barabel/steevenson-screen/docs/phases/README.md

# Щит для POK005L — фазы

> Утверждено картой `.scratch/shield/map.md` (тикет «Утвердить план фаз»).

ТЗ: [PLAN.md](../PLAN.md). Термины: [GLOSSARY.md](../../GLOSSARY.md).

Порядок — сверху вниз от Скелета: сначала точный Датчик, потом Скелет всего Щита из Черновиков, потом детализация деталей, каждая берёт размеры из Скелета. Spec фазы пишется в её grilling-сессии: `.scratch/<фаза>/spec.md`.

Все Стыки — именованные параметры Скелета в одном файле. Фазы их только читают; поменять Стык — править Скелет и запустить Прогон. Поэтому фазы 4, 5, 6 друг от друга не зависят и идут в любом порядке.

## 0. Окружение

- **статус**: готово (PR #1)
- **цель**: воспроизводимый Прогон из VS Code
- **вход**: —
- **выход**: структура репо (`res/` — внешние ресурсы, только чтение; `src/` — наш код; `dist/` — результат Прогона, в `.gitignore`); `build.cmd` (или Ctrl+Shift+B) делает Прогон и сохраняет `dist/shield.FCStd`, `build.cmd test` запускает тесты; заготовка проверок геометрии (битое тело или пересечение деталей роняет Прогон с понятной ошибкой, каждая фаза добавляет свои); Прогон сохраняет PNG-виды сцены (спереди, сбоку, сечение по оси) в `dist/views/`, чтобы агент видел результат. Резервный путь рендера, если offscreen в FreeCAD сломается: GUI-рендер `freecad.exe` или OpenSCAD по экспортированным STL
- **готово, когда**: один запуск `build.cmd` из терминала VS Code даёт файл, который открывается в FreeCAD, и PNG-виды; намеренно битое тело роняет Прогон

## 1. Контрольная сцена Датчика

- **статус**: готово
- **цель**: узнать реальную геометрию Датчика
- **вход**: 0
- **выход**: импорт STL половин Корпуса и Вешалки, половины свинчены, понятно как Ушко цепляется за Вешалку; реальный габарит Датчика и упрощённое тело — Заглушка
- **готово, когда**: габарит собранного Датчика измерен в сцене, Заглушка его повторяет

## 2. Скелет Щита

- **статус**: готово
- **цель**: общая параметрическая модель всего Щита из Черновиков
- **вход**: 1
- **выход**: параметры и оси, Черновики всех деталей (Тарелки, Нижняя Тарелка с резьбовым кольцом, Крышка, Стойки, Дно, Держатель, Кронштейн), Заглушка внутри на Крючке Держателя. Стыки — параметры в одном файле `src/skeleton/params.py`, стартовые значения, мм:
  - Тарелки: наружный Ø 140, Ø отверстия 76, N = 6 (с Нижней, без Крышки), шаг 16
  - Крышка↔Кронштейн: Точка подвеса (центр верха Крышки, ось болта = ось Щита), болт M6, Проставка 20
  - Тарелки/Крышка↔Стойки: 4 Стойки на радиусе 54, отверстие 4.5 под Шпильку M4
  - Дно↔Нижняя Тарелка: резьба Ø 90 × шаг 5, наклон стороны 45°, зазор 0.5 по нормали к профилю (ориентир SanglierLab с запасом, без печати Пробника)
  - Щит↔Откос: от Фасада до края Тарелок 150, сдвиг вбок от плоскости Откоса 100
  - Датчик↔Держатель: форма Крючка (из фазы 1)

  От Фасада до оси Щита выводится: 150 + радиус Тарелки = **220** при Ø 140. После фазы 4: Ø 154, N = 7, **227**
- **готово, когда**: все Стыки — параметры в одном файле; после смены диаметра Щита и числа Тарелок Прогон строит Скелет без ошибок; Заглушка не ближе 10 мм ни к одному телу, кроме Держателя; Дно с Держателем и Датчиком выходит вниз без столкновений; проверки фазы 0 проходят

## 3. Пробник резьбы

- **статус**: закрыта без печати. Принтер друга сломался, все детали печатаются одним заказом в мастерской. Зазор в Скелете — 0.5: ориентир SanglierLab с запасом; не подойдёт — перепечатать Дно (весь зазор на нём, кольцо Нижней Тарелки номинальное)
- **цель**: модуль резьбы для Дна и Нижней Тарелки; печать Пробника отменена
- **вход**: 2 (диаметр, шаг, зазор резьбы)
- **выход**: модуль резьбы для Нижней Тарелки (фаза 4) и Дна (фаза 5); Пробник — 4 кольца на один стол (Кольцо Тарелки и Кольца Дна 0.3 / 0.4 / 0.5), `dist/coupon.FCStd` и STL в `dist/coupon/`. Прогон строит Пробник и дальше: его проверка пары — тест модуля резьбы
- **готово, когда**: Прогон строит Пробник, проверки пары проходят; зазор записан в Скелет

## 4. Тарелки и стопка

- **статус**: готово
- **цель**: Тарелки, которые закрывают Носик от солнца
- **вход**: 2, 3 (модуль резьбы)
- **выход**: профиль Тарелки по мотивам SanglierLab — Полка у отверстия, Капельник, конус 45° от наружного края Полки; печать Полкой на стол без поддержек. Тарелки ×N (N = 7 с Нижней, без Крышки), Ø 154. Крышка с плоским верхом, снизу — гнездо под гайку M6 болта подвеса (гайку вставляют при Сборке). Нижняя Тарелка без Капельника, резьбовое кольцо с витками модулем резьбы фазы 3, номинальный размер. Стойки на Полке под Шпильки M4, гайки M4 с шайбами снаружи: на верху Крышки и под Полкой Нижней Тарелки. Новые проверки Прогона: тень, просвет, шайба у кольца
- **готово, когда**: прямое солнце на высоте 0–90° с любого направления не попадает ни в одну точку Заглушки; просвет между соседними Тарелками ≥ 9 мм; Прогон и все проверки проходят

## 5. Дно и Держатель

- **статус**: готово
- **цель**: съёмное Дно с Датчиком
- **вход**: 2, 3
- **выход**: Дно — одна деталь: сверху Диск, он упирается в низ Полки Нижней Тарелки (единственный упор); вниз от него Обечайка с наружной резьбой модулем резьбы фазы 3, зазор из Скелета (0.5), весь на Дне; ниже резьбового кольца с зазором — рифлёный хват, верх скошен 45°; дренаж — отверстия в Диске по окружности. Печать Диском на стол без поддержек. Держатель — одна деталь: Пятка на Диске, пластина за спиной Корпуса, Крючок по форме Вешалки (одна дуга, кончик вверх) заодно с Держателем; печать на боку. Держатель на двух винтах M4 через Диск и Пятку: головки снизу, гайки с шайбами на Пятке. Датчик висит Носиком вниз. Новые проверки Прогона: висит на Крючке, пара резьб; выход вниз — путь Дна с Нижней Тарелкой не сравнивается
- **готово, когда**: Заглушка висит на Крючке Носиком вниз; пара резьб и выход вниз проходят; Прогон и все проверки проходят

## 6. Кронштейн

- **цель**: Щит висит на покупном Кронштейне за Крышку

Кронштейн ещё не куплен, поэтому фаза разделена: 6а — форма по ориентировочным размерам сейчас, 6б — обмер после покупки. Проверки 6а — критерии покупки в модели: в 6б Прогон с обмером скажет, подходит ли купленное.

### 6а. Форма и Проставка по ориентировочным размерам

- **статус**: готово
- **вход**: 2 (Точка подвеса, болт M6, высота Проставки), 4 (верх Крышки с гнездом гайки M6), форма по эскизу [docs/sketches/kronshtein-na-otkose.html](../sketches/kronshtein-na-otkose.html). Spec: `.scratch/bracket/spec.md`
- **выход**: пакет Кронштейна `src/bracket/` вместо Черновика Кронштейна, Черновиков в Скелете больше нет. Уголок — вдоль Откоса от рамы за Фасад; Поворот — стойкой вверх, с подкосом, на двух болтах M6 к концу Уголка, плечо внизу. Проставка с пазом под плечо Поворота, печать низом на стол. Стык Щит↔Откос: от Фасада до края Тарелок 150, сдвиг оси Щита вбок от плоскости Откоса 100. Новые проверки Прогона: «сбоку от Щита пусто», «гайки в углу», «ключ к болту». Прогон пишет в лог длину Уголка и положение болта подвеса на Повороте
- **готово, когда**: Прогон и все проверки проходят

### 6б. Обмер купленного

- **статус**: —
- **вход**: 6а; купленные и обмеренные Уголок и Поворот (что купить и что обмерить — тикет [.scratch/bracket/issues/01-chto-kupit.md](../../.scratch/bracket/issues/01-chto-kupit.md))
- **выход**: обмер в параметрах Скелета `src/skeleton/params.py`, код моделей не меняется
- **готово, когда**: Прогон с обмером проходит

## 7. Печать

- **статус**: —
- **цель**: детали готовы к печати
- **вход**: 4, 5, 6; замер собранного Датчика штангенциркулем, сверка с параметрами Датчика
- **выход**: STL каждой детали, уже повёрнутые на стол, проверка нависаний, экспорт FCStd; лист заказа для мастерской: детали, количество, материал (белый ASA, если мастерская его печатает, иначе белый PETG), ключевые настройки. Печать одним заказом, нарезает мастерская. Расчётный стол — 220×220×250, пока мастерская не выбрана
- **готово, когда**: у каждой детали есть STL, повёрнутый на стол, и лист заказа готов

## 8. Инструкция

- **статус**: —
- **цель**: README для печати, сборки и смены батарейки
- **вход**: 7
- **выход**: `README.md`; после печати — рядом с зазором в Скелете: мастерская, материал, дата, подошло ли Дно
- **готово, когда**: в README есть разделы «печать», «сборка», «монтаж», «смена батарейки»
