barabel/steevenson-screen/GLOSSARY.md

# Щит для POK005L

Самодельная пассивная защита уличного датчика температуры/влажности от прямого солнца и осадков у окна квартиры.

## Конструкция

**Щит**:
Вся защитная конструкция вокруг Датчика: стопка Тарелок с Крышкой и Дном. Технически — радиационный экран типа Gill.
_Avoid_: метеобудка, будка, экран, Stevenson screen

**Тарелка**:
Один кольцевой экранирующий ярус Щита; тарелки одинаковые по профилю и перекрывают друг друга так, что прямой свет не проходит внутрь.
_Avoid_: ярус, пластина, жалюзи, cup

**Полка**:
Плоское кольцо Тарелки вокруг отверстия, от него наружу и вниз идёт конус; на Полке стоят Стойки.
_Avoid_: фланец, площадка, shelf

**Капельник**:
Бортик по краю отверстия Тарелки, свисающий с Полки вниз и внутрь.
_Avoid_: губа, юбка, lip

**Нижняя Тарелка**:
Самая нижняя Тарелка Щита: профиль как у Тарелки, но без Капельника, плюс резьбовое кольцо, на которое навинчивается Дно.
_Avoid_: base, нижний ярус

**Крышка**:
Верхняя глухая Тарелка Щита, закрывает его сверху от солнца и осадков.
_Avoid_: top, верх

**Дно**:
Съёмная нижняя деталь Щита, навинчивается на Нижнюю Тарелку; снимается для доступа к Датчику.
_Avoid_: base, основание

**Стойка**:
Вертикальный выступ Тарелки до соседней Тарелки, через который проходит Шпилька; печатается заодно с Тарелкой.
_Avoid_: колонна, бобышка, post

**Шпилька**:
Резьбовой стержень M4, стягивающий все Тарелки и Крышку в одну стопку.
_Avoid_: болт, винт

**Держатель**:
Отдельная деталь, привинченная к Дну, на Крючке которой Датчик висит внутри Щита; уходит из Щита вместе с Дном.
_Avoid_: sensor holder, крепление датчика

**Пятка**:
Горизонтальная опора Держателя, которой он лежит на Дне и через которую привинчен к нему.
_Avoid_: основание, подошва, foot

**Кронштейн**:
Покупная металлическая сборка из Уголка и Поворота, которой Щит крепится к Откосу; Щит висит под Поворотом за Крышку.
_Avoid_: подвеска, mount, крепёж

**Уголок**:
Часть Кронштейна вдоль Откоса, от рамы за Фасад; крепится анкерами в кирпич Откоса.
_Avoid_: профиль, рейка

**Поворот**:
Часть Кронштейна от конца Уголка вбок, от проёма, до Точки подвеса.
_Avoid_: полочный кронштейн, консоль

**Проставка**:
Печатная деталь между верхом Крышки и Поворотом; сквозь неё проходит болт Точки подвеса.
_Avoid_: втулка, шайба, spacer

**Точка подвеса**:
Центр верха Крышки, где болт держит Щит на Кронштейне; ось болта совпадает с осью Щита.
_Avoid_: подвес, точка крепления

**Откос**:
Кирпичная боковая стенка оконного проёма снаружи окна.
_Avoid_: стена, бок окна, рама

**Фасад**:
Наружная плоскость стены дома вокруг окна; Откос уходит от неё внутрь к раме.
_Avoid_: стена

**Скелет**:
Общая упрощённая модель всего Щита с ключевыми размерами, осями и местами стыков. Каждая деталь берёт размеры из Скелета, а не у соседних деталей.
_Avoid_: болванка, каркас, layout

**Черновик**:
Упрощённое тело детали в Скелете: задаёт её место и габарит, пока саму деталь не спроектировали в её фазе.
_Avoid_: болванка, грубое тело, placeholder

**Стык**:
Место, где сопрягаются две детали, которые проектируются в разных фазах; его размеры задаёт Скелет, а не одна из деталей.
_Avoid_: интерфейс, контракт, соединение

**Сборка**:
Физическое соединение напечатанных деталей и крепежа в готовый Щит.
_Avoid_: сборка в смысле запуска скрипта, build

**Прогон**:
Один запуск скрипта, который заново строит модель Щита, её виды и проверки.
_Avoid_: сборка, билд, build

**Пробник**:
Набор небольших тестовых фрагментов деталей, которые печатают за раз до основной печати, чтобы подобрать зазор.
_Avoid_: тестовый образец, тест-принт

## Датчик

**Датчик**:
ПушОк POK005L в сборе: Корпус и Носик.
_Avoid_: сенсор, шайба

**Корпус**:
Круглая часть Датчика из двух свинчивающихся половин, внутри — батарея и электроника.
_Avoid_: шайба, puck

**Носик**:
Рёбристый выступ Корпуса с чипом температуры/влажности — чувствительная часть Датчика.
_Avoid_: выступ, щуп, хвостик, probe

**Ушко**:
Кольцо на Корпусе напротив Носика, которым Датчик надевается на Крючок или Вешалку.
_Avoid_: петля, проушина, eye

**Крючок**:
Зацеп на Держателе, на который вешается Датчик; повторяет форму крючка Вешалки, печатается заодно с Держателем.
_Avoid_: hook, подвеска

**Вешалка**:
Штатная настенная деталь производителя: пластина с крючком, на которую Датчик вешается за Ушко. В Щит не входит, служит образцом для Крючка.
_Avoid_: hook, штатный крючок, кронштейн

**Заглушка**:
Упрощённое твёрдое тело, повторяющее габарит и форму Датчика; стоит в модели вместо точной формы Датчика.
_Avoid_: болванка, макет, stub, dummy
