barabel/steevenson-screen/docs/map.md

# Щит для POK005L — карта фаз

Исходное ТЗ: [docs/PLAN.md](PLAN.md). Термины: [GLOSSARY.md](../GLOSSARY.md).

## Фазы

0. **Окружение** — структура репо (`models/`, `src/`, `output/`), запуск `freecadcmd src/build.py` из VS Code, пустая сборка даёт FCStd.
1. **Контрольная сцена** — импорт STL Датчика и Крючка, свинтить половины Корпуса, понять как цепляется Крючок. Итог: реальный габарит Датчика и упрощённое тело-заглушка для дальнейших фаз.
2. **Профиль Тарелки** — перенести профиль SanglierLab, пересчитать под полость; проверить в сечении, что низкое солнце (0–15°) не видит Носик.
3. **Стопка** — Тарелки ×N, Крышка, нижняя Тарелка с резьбой под Дно, Стойки под Шпильки M4.
4. **Дно и Держатель** — резьба Дна, Держатель с Крючком, Датчик висит Носиком вниз, извлечение снизу.
5. **Кронштейн** — узел на Крышке + Кронштейн в Откос на дюбеле.
6. **Печать** — разбивка на детали, ориентация на столе, допуски, экспорт STL/FCStd, тестовый образец резьбы.
7. **Инструкция** — README: печать, сборка, смена батарейки.

## Решения

- инструмент: FreeCAD 1.1, Python-скрипт — источник истины, GUI только для просмотра
- концепция Щита — как SanglierLab: стопка одинаковых Тарелок, 4 Стойки со Шпильками M4, резьбовое Дно
- Щит висит на Кронштейне за Крышку; Датчик снимается вниз вместе с Дном
- Датчик висит вертикально, Носик вниз, на Крючке; Крючок — часть Держателя (одна деталь), не Крышки: Датчик выезжает с Дном, далеко от горячей Крышки
- Кронштейн крепится в кирпичный Откос через дюбель; печатный или покупной — открыто
- детали печатаются по отдельности
- пока проектируем под стол 220×220, белый PETG (уточнить у друга)

## Туман

- Кронштейн: печатный или покупной; геометрия Откоса и вылет
- точный принтер и пластик
- число Тарелок, итоговые диаметр/высота — после фазы 2
