barabel/steevenson-screen/docs/PLAN.md

# Проект: компактный уличный метеоэкран для датчика POK005L

## Цель

Спроектировать небольшую, аккуратную и пригодную для 3D-печати защитную конструкцию для беспроводного датчика температуры **ПушОк POK005L**. Датчик будет установлен **снаружи окна квартиры**. Вечером в окно светит прямое солнце; без защиты корпус датчика может нагреваться и завышать показания относительно температуры воздуха. Нужен **пассивный радиационный экран**, а не герметичный контейнер или большая классическая квадратная метеобудка.

Датчик должен измерять уличный воздух, а не температуру нагретой оконной рамы, стекла или подоконника. Продумать удаление от этих поверхностей с учётом ограниченного пространства у окна.

## Что требуется от конструкции

- Компактный белый экран, желательно в форме нескольких горизонтальных пластин/жалюзи (тарельчатый Stevenson/Gill-style radiation shield), который перекрывает прямую видимость датчика для солнечных лучей под разными углами, включая низкое вечернее солнце.
- Свободная естественная циркуляция воздуха вокруг чувствительной части датчика; защита от осадков, не герметичная коробка.
- Возможность установить и извлечь POK005L для смены батарейки, не демонтируя всю конструкцию с окна. Не перекрывать отверстия датчика, если они есть.
- Предусмотреть съёмное внутреннее крепление под его геометрию и безопасное крепление самого экрана к кронштейну/оконной конструкции. Способ крепления к окну пока не определён — сделать его модульным и согласовать с пользователем.
- Подготовить геометрию к FDM-печати: разъёмные детали, разумные допуски, минимум поддержек, подходящие соединения и инструкции по ориентации на столе. Рекомендуемый материал: белый PETG; ASA возможен при наличии соответствующего принтера. Экран должен переживать морозы порядка −30 °C и летнее солнце.
- Проект — практическая самодельная защита, не поверенный метеоприбор. При оценке качества учитывать также локальный нагрев фасада и слабую вентиляцию.

## Входные файлы датчика

Пользователь предоставил **две STL-половины корпуса**, которые соединяются резьбой:

- `pok5L-btm.stl` — bounding box ~ **50.20 × 73.33 × 13.60 мм** (в исходной ориентации X×Y×Z).
- `pok5l-Top.stl` — bounding box ~ **50.20 × 50.20 × 13.00 мм** (X×Y×Z).

Размеры получены измерением мешей STL с предположением, что их единицы — миллиметры. Вытянутый габарит 73.33 мм у нижней половины, вероятно, включает выступ/крепление; **это необходимо проверить визуально**. Детали в STL расположены разнесённо по координатам; перед сборкой нужно правильно соосно сопоставить резьбовые половины, а не просто сложить габариты. **Высота собранного корпуса пока неизвестна**, поскольку части заходят друг в друга при свинчивании. Не объявлять сумму толщин (26.6 мм) точной высотой собранного датчика.

Эти два STL должны находиться в папке проекта, например `models/`. Если отсутствуют, запросить файлы у пользователя; не подменять их придуманной моделью.

## Предварительная концепция экрана (не финальные размеры)

- Внешний диаметр ориентировочно **110–120 мм**.
- Высота ориентировочно **100–110 мм** (допускается изменение после реальной компоновки).
- Около **6–7 экранирующих ярусов**, зазор между ними приблизительно **10–12 мм**.
- Внутренняя полезная полость ориентировочно **75–85 мм**, но подбирать по собранному POK005L с достаточными воздушными зазорами.
- Светлые непрозрачные пластинки с перекрытием линий прямого света. Конструкция должна реально экранировать низкое вечернее солнце: просто несколько плоских дисков без перекрывающих жалюзи могут не подойти.
- Желательно конструкция со съёмным нижним элементом и держателем датчика, внешними стойками и возможностью вывода кронштейна.

Это **стартовые ориентиры, не зафиксированное ТЗ**. Приоритет — достаточная вентиляция, солнечное экранирование и обслуживаемость, а не минимальный размер любой ценой.

## Рабочий процесс: VS Code + Codex/ChatGPT + FreeCAD

Пользователь пишет и редактирует проект в **VS Code**, использует расширение ИИ или запускает агента из терминала. Целевая программа — **FreeCAD** на локальном компьютере.

**Основной источник истины — текстовые Python-скрипты**, которые через API FreeCAD создают параметрическую модель. Не полагаться на несохранённые ручные изменения геометрии в GUI: повторный запуск скрипта должен воспроизводить проект. При этом мышкой в FreeCAD можно вращать, скрывать/показывать, измерять и осматривать модель.

Желательно хранить:

```text
pok005l-weather-shield/
├── CONTEXT.md
├── models/
│   ├── pok5L-btm.stl
│   └── pok5l-Top.stl
├── src/
│   └── build.py          # основной Python-скрипт FreeCAD
├── output/               # сгенерированные FCStd и STL
└── README.md             # запуск и инструкция по печати/сборке
```

Точную структуру можно поменять по необходимости. Цель — один воспроизводимый запуск сборки модели; не смешивать исходники с генерируемыми STL. Скрипт должен использовать доступный Python API установленной версии FreeCAD и предоставлять параметры (диаметры, высоты, зазоры, толщины, крепёж), легко редактируемые через VS Code. Можно запускать макрос из самого FreeCAD или настроить командный запуск — после уточнения версии и ОС.

## Первые задачи для агента

1. Уточнить версию FreeCAD и способ запуска скриптов на пользовательском ПК.
2. Импортировать обе STL-половинки в контрольную сцену FreeCAD, визуально проверить ориентацию, резьбу, посадку и реальные размеры собранного корпуса. Не пытаться сразу булево вычитать сверхтяжёлые меши: при необходимости использовать их как визуальные референсы или строить упрощённую геометрию габарита.
3. Сделать первый параметрический макет экрана вокруг собранного датчика и отдельный крепёж. Проверить солнечное перекрытие при боковом низком свете и возможность вентиляции.
4. Организовать отдельные детали для печати, проверку зазоров и сборки, экспортировать STL и по возможности FCStd.
5. Подготовить краткую инструкцию по печати и сборке, включая материалы, ориентацию деталей, крепёж, и способ снятия датчика.

## Что ещё согласовать

- Точное положение корпуса в экранe, способ захвата за штатный выступ; какой стороной направлены вентиляционные отверстия/измерительный элемент.
- К чему именно и как пользователь может закрепить экран за окном (рама, откос, кронштейн, существующий крючок), допустимый вылет от стены/стекла.
- Размер стола/возможности доступного 3D-принтера, желательно тип крепежа без дополнительных покупок.
- Фактические габариты *собранного* датчика по совмещённым STL, а также удобство замены батарейки.

## Критерий готовности

Проект должен содержать воспроизводимый Python-код модели FreeCAD, визуализацию POK005L внутри экрана, отдельные STL для печати, логичную схему крепления и разборки, и краткую инструкцию. При этом экран остаётся компактным и защищает от низкого вечернего солнца лучше, чем простой козырёк.
