barabel/steevenson-screen/res/pok005lv2/pok5L-btm.stl

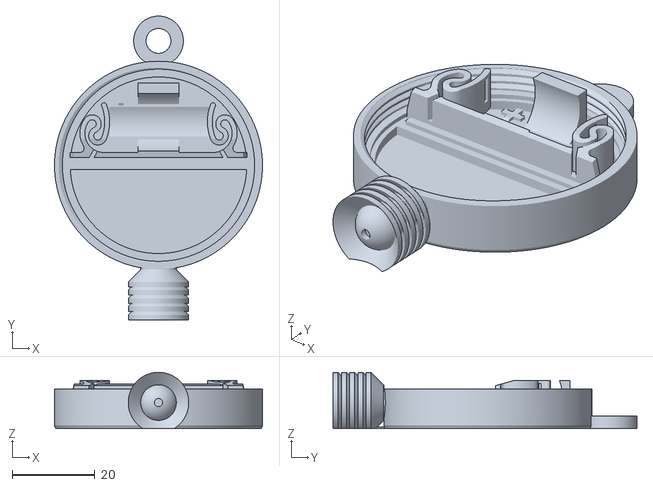
[picture p1: CAD file, 2026-10-18]
res/pok005lv2/pok5L-btm.stl
50.2 x 73.3 x 13.6
