barabel/steevenson-screen/res/SanglierLab/Top.stl

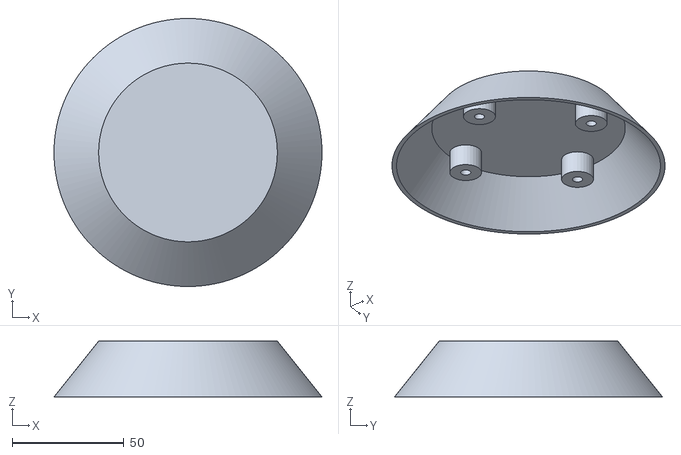
[picture p2: CAD file, 2026-10-18]
res/SanglierLab/Top.stl
120.0 x 120.0 x 25.0
