barabel/steevenson-screen/res/pok005lv2/pok5l-Top.stl

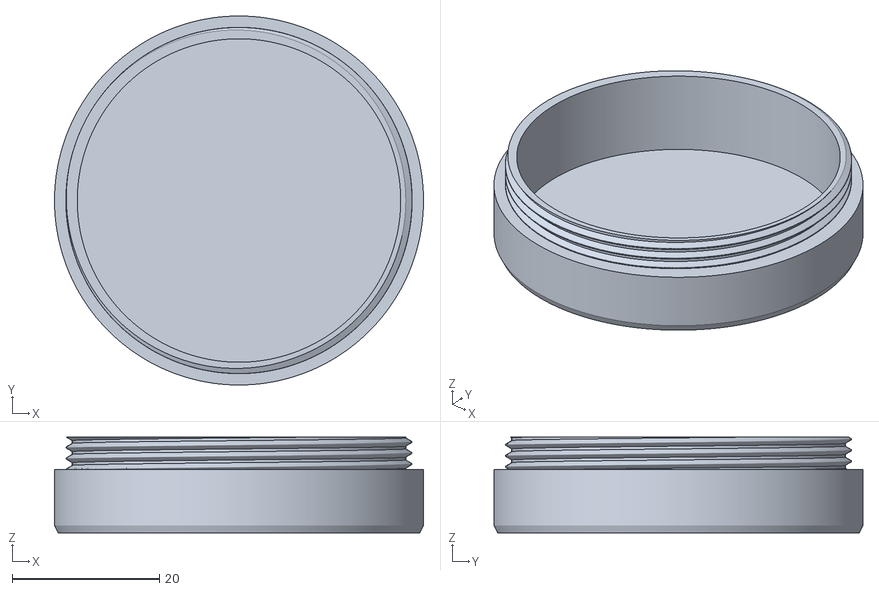
[picture p3: CAD file, 2026-10-18]
res/pok005lv2/pok5l-Top.stl
50.2 x 50.2 x 13.0
