barabel/steevenson-screen/res/SanglierLab/Middle.stl

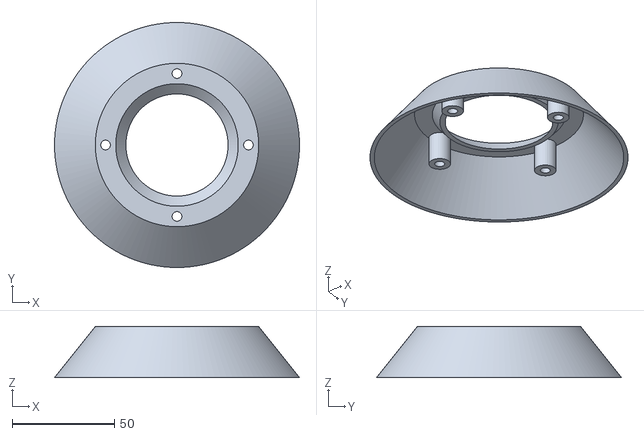
[picture p4: CAD file, 2026-10-18]
res/SanglierLab/Middle.stl
120.0 x 120.0 x 25.0
