barabel/steevenson-screen/res/pok005lv2/pok5l-Hook.stl

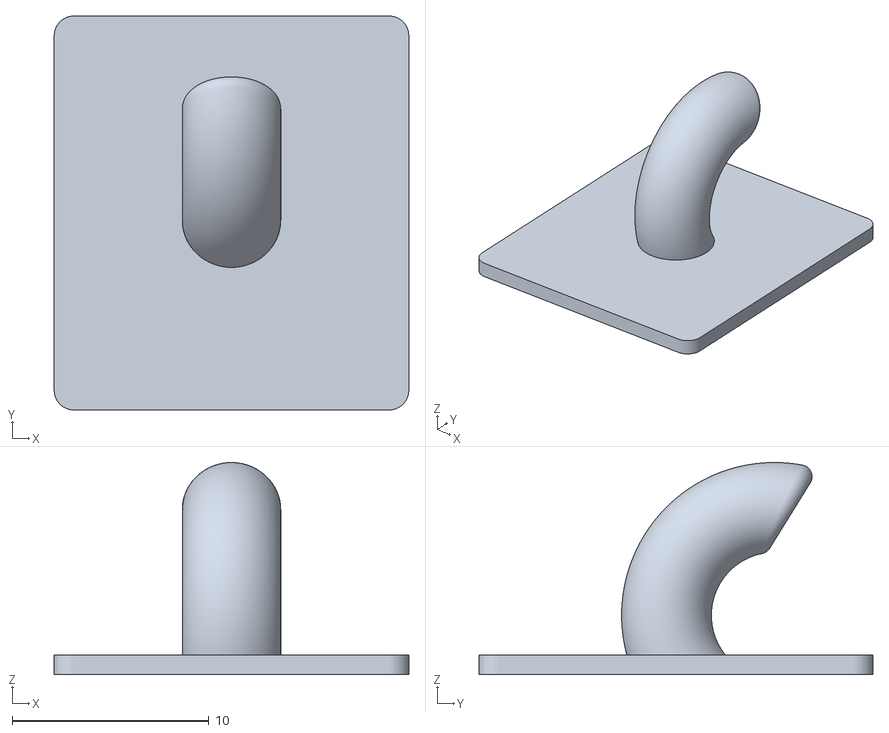
[picture p5: CAD file, 2026-10-18]
res/pok005lv2/pok5l-Hook.stl
18.0 x 20.0 x 10.8
