barabel/steevenson-screen/res/SanglierLab/SensorHolder.stl

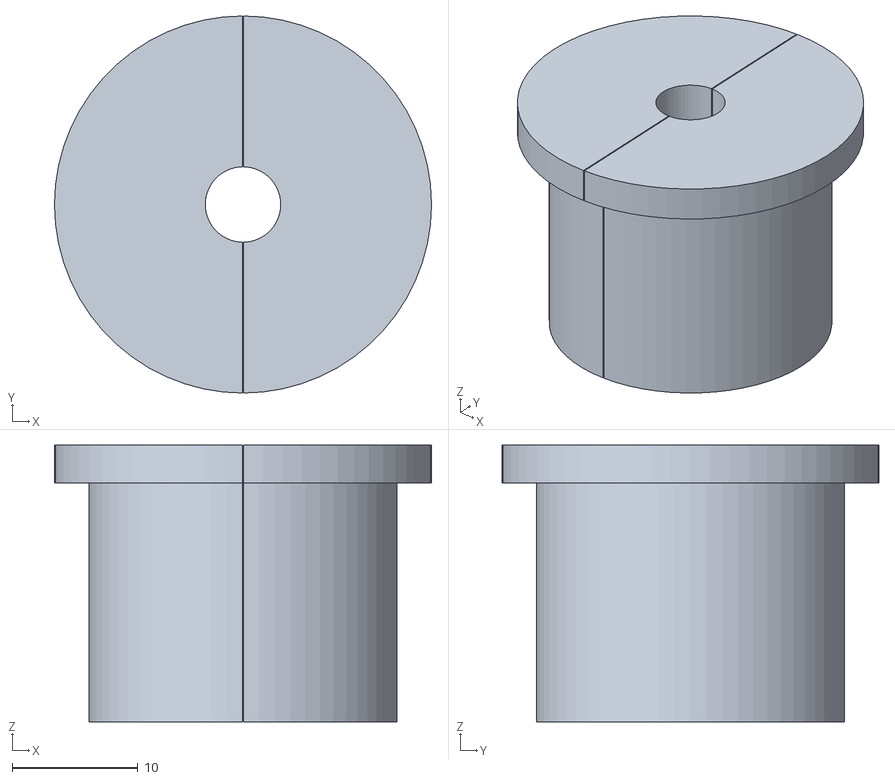
[picture p6: CAD file, 2026-10-18]
res/SanglierLab/SensorHolder.stl
30.0 x 30.0 x 22.0
