barabel/steevenson-screen/res/SanglierLab/Bottom.stl

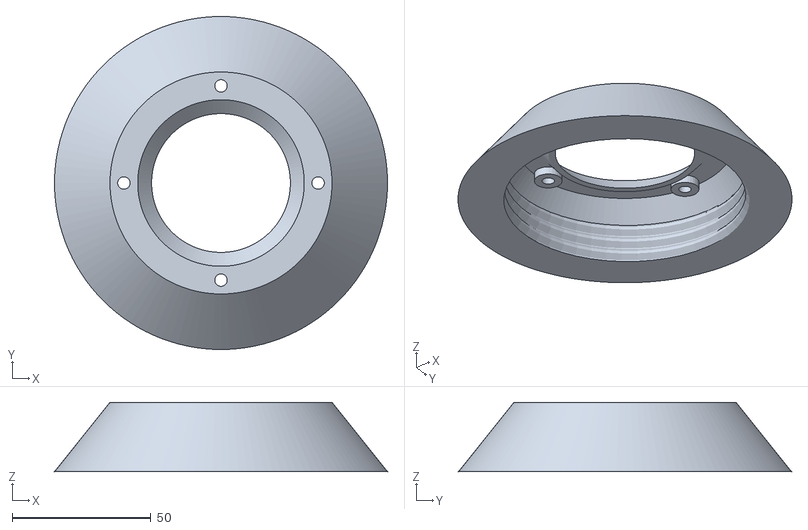
[picture p7: CAD file, 2026-10-18]
res/SanglierLab/Bottom.stl
120.0 x 120.0 x 25.0
