barabel/steevenson-screen/res/SanglierLab/Base.stl

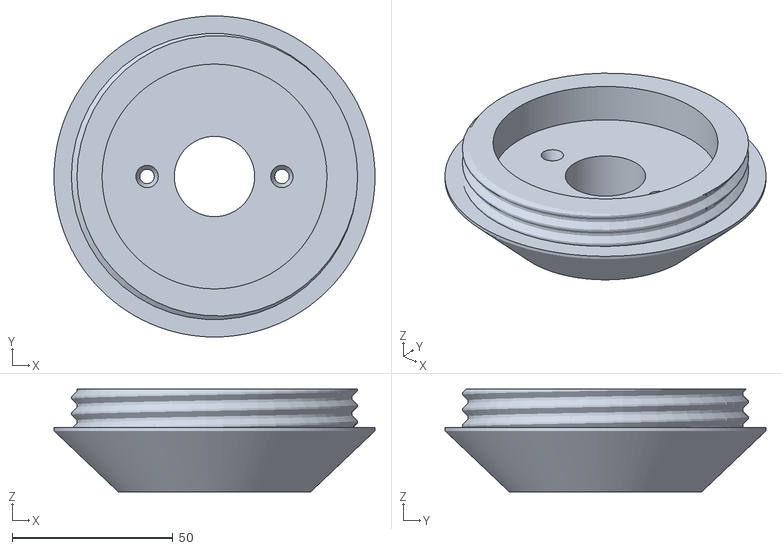
[picture p8: CAD file, 2026-10-18]
res/SanglierLab/Base.stl
100.0 x 100.0 x 32.0
