barabel/steevenson-screen/(commit log)

2026-10-18 карта фаз: черновик docs/phases, Скелет в глоссарии
2026-10-18 карта щита: кронштейн покупной, щит висит за крышку
2026-10-18 план фаз утверждён: 9 фаз, Стыки в Скелете, Пробник резьбы
2026-10-18 глоссарий: Сборка и Прогон
2026-10-18 Прогон: build.cmd → dist/shield.FCStd, код 1 на исключении, build.cmd test
2026-10-18 README фаз: Прогон, build.cmd, dist/ и res/
2026-10-18 проверки геометрии: isValid, 1 solid, объём > 0, пересечения пар; код 1
2026-10-18 виды: front/left/section PNG без окна, срез закрашен, сбой рендера → код 1
2026-10-18 битое тело не роняет Прогон до проверок
    views: тела без граней пропускаются; сбой рендера → ошибка в списке, проверки идут; checks: null-форма → ошибка isValid вместо OCCError; тесты: битая сцена, плоский solid, null; пути из build, без unittest.main
2026-10-18 build.cmd: комментарий — Прогон
2026-10-18 глоссарий: Ушко, Вешалка, Заглушка; статусы фаз
2026-10-18 меши-референсы Датчика в Прогоне
    пакет sensor: Заглушка фазы 0 + STL Корпуса и Вешалки как Mesh::Feature. scene.build → (тела, референсы), проверки пакетов — scene.checks(). Виды: меши полупрозрачные синие, в разрезе — SoClipPlane.
2026-10-18 Датчик свинчен и висит на Вешалке
    меши в позе висения: начало — центр отверстия Ушка, Носик вниз, ось резьбы по X. Глубина свинчивания 4.4 мм — параметр sensor.params.SCREW_DEPTH, найдена по мешам один раз
2026-10-18 Заглушка Датчика из параметров, проверка габарита
    диск Корпуса + Носик + Ушко с отверстием; габарит сверяется с мешами половин Корпуса, расхождение > 0.5 мм по оси — ошибка
2026-10-18 параметры крючка Вешалки и угол наклона Датчика
    README фаз: фаза 1 готова, фазе 7 — замер Датчика
2026-10-18 разрез: сечения мешей линиями поверх среза Заглушки
    видны резьба и стык половин Корпуса; меши освещены с двух сторон — Вешалка в разрезе своим цветом
2026-10-18 термины глоссария: Заглушка — plug, крючок Вешалки — HANGER_*
    STUB/stub()/Stub → PLUG/plug()/Plug, тесты test_plug_*; HOOK_* → HANGER_*; README фазы 1: «Заглушка» с большой; makeCylinder Ушка в столбик
2026-10-18 меши: EYE → EAR, Placement меша — в одном месте
    placed() общий для load() и case_box(); длинная строка screwed_top развёрнута
2026-10-18 глоссарий: Нижняя Тарелка, Черновик, Точка подвеса; Стойка — выступ Тарелки
    AGENTS.md: термины глоссария в ответах — жирным
2026-10-18 Скелет: стопка Тарелок из параметров
    пакет skeleton: Крышка, Тарелки, Нижняя Тарелка со Стойками; Датчик ставится в Щит сдвигом из Скелета; тест Скелета из параметров
2026-10-18 Скелет: Дно, Держатель, резьбовое кольцо; Датчик над Дном
    Стойки на радиусе 54: снаружи кольца, место под гайку M4
2026-10-18 Скелет: Черновик Кронштейна, вылет в лог
2026-10-18 Скелет: проверка зазора Заглушки
2026-10-18 Скелет: проверка выхода вниз Дна, Держателя, Заглушки
    по радиусам: цилиндр вокруг оси до низа Щита
2026-10-18 README фаз: фаза 2 готова, стартовые значения, вылет Кронштейна, термины
2026-10-19 Скелет: зазор Заглушки с точностью 0.01 мм, формат ошибки как в checks
2026-10-19 Скелет: проверка зазора Крючок↔Крышка
2026-10-19 Скелет: проверка Стойки↔резьбовое кольцо Нижней Тарелки
2026-10-19 Датчик читает перенос Скелета при вызове: без циклического импорта; PLUG — из sensor
2026-10-19 тест Прогона: все Тарелки в метках Черновиков
2026-10-19 README фаз: угол профиля резьбы Дна
2026-10-19 Скелет: термины глоссария, dish_run, именованные константы, докстринги
2026-10-19 Глоссарий: Пробник — набор фрагментов
2026-10-19 Скелет: профиль зуба резьбы Дна — наклон стороны, глубина, фаска
2026-10-19 Пробник: пара колец, модуль резьбы, проверка пары
    Прогон строит Пробник в dist/probe.FCStd и STL колец в dist/probe. Резьба: makeLongHelix(..., 0) + MakePipeShell binormal, зазор — offset профиля по нормали, фаска в теле вращения.
2026-10-19 Пробник: набор 0.3/0.4/0.5 сеткой 2×2, насечки, проверка стола
    Фаска на нижнем торце наружной резьбы. Пара соосна по Placement: габарит врёт на 1e-7, common на отрицательном зазоре молча давал пустоту.
2026-10-19 Пробник: чек-лист визита в print/, README фаз 3 и 7
2026-10-20 Пробник: код coupon вместо probe
2026-10-20 Пробник: соосность пары по габариту с округлением, не по Placement
2026-10-20 Резьба: фаска нижнего торца — по запросу, только у колец Дна; BEYOND вместо +1
2026-10-20 Пробник: bodies_in/errors вместо дублей в Прогоне и тестах, export_coupon_stl, докстринги
2026-10-20 Чек-лист Пробника: правило выбора с пропуском, второй набор, без «крышки»
2026-10-21 Резьба Дна: зазор 0.5 по SanglierLab, печать без Пробника
    Принтер друга сломался, все детали печатаются одним заказом в мастерской. Фаза 3 закрыта без печати: код Пробника остаётся как тест модуля резьбы, чек-лист визита удалён. README фаз: покупка Кронштейна — отдельный тикет, фаза 7 — STL на стол и лист заказа (ASA или PETG), фаза 8 — запись после печати.
2026-10-21 Глоссарий: Полка и Капельник
2026-10-21 Пакет стопки: Крышка, Тарелки и Нижняя Тарелка из Скелета в src/stack
    Скелет строит Дно, Держатель и Кронштейн. Проверка Стойки↔резьбовое кольцо переехала в пакет стопки, метки и текст ошибки прежние.
2026-10-21 Проверка просвета: соседние тела стопки не ближе 9 мм
    Меряется по сечению через ось посередине между Стойками; ошибка называет обе метки и просвет в мм. Тесты: подставные Тарелки в 5 мм и шаг 12.
2026-10-21 Проверка тени: лучи к солнцу от точек Заглушки, высота 0–90°, весь круг
    Пакет стопки: stack/shadow.py, тела триангулируются, лучи — Möller–Trumbore матрицами numpy. Шаг 5° по высоте, 15° по направлению, точки — вершины грубой триангуляции Заглушки. Тесты: Заглушка одна, в замкнутой коробке, без Заглушки, шаг 30.
2026-10-21 Профиль стопки: Полка и конус 45°, Стойки с Полки на Полку
    Наружный Ø 154, Полка до r62, вынос конуса 15, Стойки на r56. Верх Дна — низ Полки Нижней Тарелки, вылет Кронштейна 227. N = 6 — наименьшее с зазором Заглушки. Тест «Ø 120 — пусто» убран: границы Ø — тикет 06.
2026-10-21 Границы Ø: Полка не помещается — ошибка с Ø и Полкой, Ø 140 — тень
    cone_run падает ValueError с Ø и радиусом Полки при выносе ≤ 0. Тесты из параметров: Ø 160 — пусто, Ø 140 — тень, Ø 120 — ошибка с Ø и Полкой; вылет Кронштейна сравнивается с Ø 140.
2026-10-21 Капельник у Тарелок 1…N−1: 4 мм ниже Полки, 5.5 внутрь
    Ø отверстия 76 мерится по нижнему краю Капельника, Полка начинается от его верхнего края. У Крышки и Нижней Тарелки Капельника нет. Тест: Капельник 8 мм — ошибка просвета.
2026-10-21 Крышка: гнездо под гайку M6 болта подвеса, N = 7
    Снизу в центре Крышки бобышка с шестигранником под гайку M6, открытым вниз, над гайкой 5 мм пластика, сквозь верх отверстие под болт. Параметры гнезда в Скелете рядом с болтом подвеса. Бобышка опускает низ Крышки к Заглушке и Крючку: при N = 6 зазоры 4.42 и 7.42 мм, наименьшее проходящее N — 7.
2026-10-21 Нижняя Тарелка: витки в резьбовом кольце и проверка шайбы M4
    Кольцо — внутренняя резьба модулем резьбы номинальным размером, как Кольцо Тарелки Пробника; спираль от низа кольца. Нижняя Тарелка без removeSplitter: с витками он ломает булевы операции (разрез PNG пустел). Черновик Дна — по сердечнику наружной резьбы r43, иначе врезается в витки кольца. Проверка шайба M4 ↔ резьбовое кольцо ≥ 2 мм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
2026-10-21 README фаз: фаза 4 готова, вылет 227 после неё
    Фаза 4: выход — Полка, Капельник, гнездо под гайку M6, Нижняя Тарелка с витками, гайки M4 снаружи; критерий — тень на всей Заглушке при 0–90°, просвет ≥ 9. Фаза 2: после фазы 4 Ø 154, N = 7, вылет 227. Фаза 3: модуль резьбы и для Нижней Тарелки.
2026-10-21 Стопка по ревью: Стойки↔кольцо из параметров, имена без shelf/lip/clearance
    Стойки↔кольцо снова ловит Стойку Ø10, заходящую на наружную стенку кольца (порог r < 54), считается из параметров, как шайба↔кольцо. SHELF_RADIUS → LEDGE_RADIUS, просвет — dish_gap, метка Тарелки — skeleton.dish_label, stack_errors общий в тестах. Глоссарий: у Нижней Тарелки нет Капельника.
2026-10-21 Просвет: DISH_MIN_CLEARANCE → DISH_MIN_GAP, как остальные зазоры между телами
2026-10-22 Глоссарий: Держатель привинчен к Дну, Пятка, Крючок заодно с Держателем
2026-10-22 Пакет Дна и Держателя: Дно и Держатель из Скелета в src/floor
    Геометрия и метки прежние, своих проверок пока нет. Скелет строит только Кронштейн; проверки зазора Заглушки, Крючок↔Крышка и выхода вниз остаются в Скелете.
2026-10-22 Дно: Диск сверху и Обечайка с витками в резьбовом кольце
    Диск — упор в низ Полки Нижней Тарелки, толщина FLOOR_DISK_THICKNESS. Обечайка — наружная резьба модулем фазы 3 с зазором Скелета, по всей длине кольца, заход с фаской у Диска. Выход вниз не сравнивает путь Дна с Нижней Тарелкой: Дно выкручивается.
2026-10-22 Держатель: Крючок по форме Вешалки и проверка «висит на Крючке»
    Крючок — дуга 104° с восьмигранным сечением 4.5 (HOOK_SECTION), центр над отверстием Ушка, Ушко лежит на внутренней стороне дуги. Крючок и пластина начинаются от одного края по Y: печать на боку. Проверка: Держатель занимает часть отверстия Ушка, иначе ошибка «Крючок», «Ушко».
2026-10-22 Дно: проверка «пара резьб» с Нижней Тарелкой
    Без пересечения; щель на поясе резьбы ниже Полки = зазору Скелета с допуском пары Пробника. Касание Диска с Полкой и всё ниже кольца в щель не входят.
2026-10-22 Дно: хват с рёбрами под резьбовым кольцом
    Обечайка продолжается ниже кольца, снаружи кольцо с пазами, верх скошен 45°, зазор до низа кольца 1 мм. Параметры хвата в Скелете.
2026-10-22 Держатель: Пятка на Диске и отверстия под винты M4 сквозь Диск и Пятку
2026-10-22 Дно: дренажные отверстия в Диске по окружности
    8 отверстий Ø5 на r32.5: внутри отверстия Нижней Тарелки r38 и снаружи Пятки с шайбами (до r27.3) при любом угле.
2026-10-22 README фаз: фаза 5 готова
    Фаза 5: выход — Дно (Диск с упором в Полку, Обечайка с резьбой, зазор из Скелета 0.5, хват, дренаж), Держатель (Пятка, пластина, Крючок по форме Вешалки) на двух винтах M4 через Диск; критерий — Заглушка висит на Крючке, пара резьб и выход вниз проходят, Прогон и все проверки проходят.
2026-10-22 Дно и Держатель по ревью: GAP_TOLERANCE в checks, угол пластины в одном месте
    GAP_TOLERANCE переехал из Пробника в checks.py рядом с MAX_OVERLAP: Дно больше не зависит от coupon. plate_corner() — привязка пластины Держателя, из неё holder() и screw_holes(). Сечение Крючка: OCTAGON_HALF_ANGLE вместо 22.5, контур замыкается как в revolved. Тест хвата в резьбовом кольце — в test_floor. HANGER_BEND_ANGLE: замер по мешу STL Вешалки.
2026-10-22 Виды: строка writeInventor() держится до readAll
    SoInput.setBuffer не копирует строку: временную освобождали до чтения, Coin читал мусор, и Прогон через раз падал на рендере больших тел (витки Дна).
2026-10-22 Тесты отверстий: винты M4 сквозь Диск и Пятку, дренаж ничем не закрыт
    Винт Ø4 проходит сквозь Дно и Держатель, вокруг отверстия до Ø7 — пластик. Путь воды от низа Носика сквозь каждое дренажное отверстие не задевает Полку Нижней Тарелки, Пятку и шайбы M4.
2026-10-22 Кронштейн: форма вдоль Откоса за Фасад с поворотом от проёма
    Термин Фасад в глоссарии. 3D-эскиз окна и Кронштейна в docs/sketches. Фаза 6: расстояния в Скелете — от Фасада и сдвиг вбок.
2026-10-22 Эскиз Кронштейна: уголок вдоль Откоса и полочный Г-кронштейн на повороте
2026-10-22 Глоссарий: Кронштейн как сборка Уголка и Поворота, Проставка
2026-10-22 Пакет Кронштейна: Черновик переезжает из Скелета
    Кронштейн строит пакет bracket в списке пакетов сцены, той же геометрией и под той же меткой; строку лога «вылет Кронштейна» пишет он же. Проверок у пакета пока нет.
    Скелет тел больше не строит: build отдаёт пустые списки, в сцене он ради своих проверок.
2026-10-22 Эскиз Кронштейна: Поворот стойкой вверх, узел подвеса и разрез стыка
    Поворот стоит стойкой вверх, плечо на уровне низа полки Уголка, подкос над плечом садится не дальше 75 мм от стойки. Камеры «Узел подвеса» (болт M6 → плечо → Проставка Ø40 с пазом → гайка в Крышке) и «Стык» (две гайки M6 с шайбами во внутреннем углу, подкос выше, зона ключа r25) — разрез по оси Щита. Подписи — термины глос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
2026-10-22 Тень: гайка болта подвеса закрывает отверстие Точки подвеса
    Плечо Поворота с отверстием под болт по оси Щита: солнце под 80° проходило сквозь отверстия Плеча и Крышки на Заглушку. В Щите там всегда гайка M6 с болтом, проверка тени загораживает лучи ею, как телом. Телом в сцене гайка не моделируется.
2026-10-22 Уголок и Поворот вместо Черновика Кронштейна
    Уголок — L вдоль плоскости Откоса со стороны проёма, от рамы минус отступ до стойки Поворота. Поворот — стойкой вверх, плечо над Крышкой на высоте проставки, за ось Щита, с отверстием под болт подвеса. Щит в 150 мм от Фасада и в 100 мм от плоскости Откоса.
    Лог пишет длину Уголка и расстояние от плоскости Откоса до болта подвеса. Параметры пре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
2026-10-22 Подкос Поворота и проверка ключа к болту подвеса
    Подкос — полоса 12×3 во внутреннем углу над плечом, садится на плечо в 75 мм от плоскости Откоса, на стойку — в 75 мм над верхом плеча; Поворот остаётся одним solid.
    Проверка Кронштейна: зона ключа r25 над плечом вокруг оси Щита не пересекается с Уголком и Поворотом; подкос на 75 мм касается её по границе, на 90 мм — ошибка «ключ».
2026-10-22 Гайки в углу: болты M6 Поворот↔Уголок и проверка места гаек
    Два болта M6 сквозь стойку Поворота и вертикальную полку Уголка, оси по X в полосе высоты полки. Проверка Кронштейна: место гайки с шайбой у внутренней стороны стойки не занято Поворотом и Уголком; нет Поворота — молчит.
2026-10-22 Проставка между верхом Крышки и плечом Поворота
    Цилиндр Ø40 высотой 20 до дна паза, сверху паз под плечо с зазором 0.25 на сторону и стенки по 3 мм, сквозь — отверстие под болт подвеса M6. Печать низом на стол, паз сверху, без поддержек.
    Тесты: болт M6 по оси Щита от верха плеча до гайки в Крышке ничего не задевает; Проставка касается Крышки и плеча, стенки паза держат плечо; метка «Проставка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
2026-10-22 Проверка «сбоку от Щита пусто»: Уголок и Поворот не ниже низа плеча
    Низ габарита тела сравнивается с низом плеча (высота проставки), допуск — GAP_TOLERANCE. Ошибка называет тело и на сколько мм оно ниже. Без тела или с null-телом проверка молчит.
2026-10-22 README фаз: фаза 6 разделена на 6а и 6б
    6а «форма и Проставка по ориентировочным размерам» — готово: пакет Кронштейна, Проставка, проверки «сбоку от Щита пусто», «гайки в углу», «ключ к болту». 6б «обмер купленного» — обмер Уголка и Поворота в параметры Скелета. В фазе 2 Стык Щит↔Откос — от Фасада до края Тарелок 150 и сдвиг вбок от плоскости Откоса 100 вместо вылета от Откоса.
2026-10-22 Термины Кронштейна по глоссарию: Проставка с заглавной, Поворот вместо полочного кронштейна
    В комментариях и докстрингах «высота проставки» — «высота Проставки». В эскизе ходовой размер — Поворота, болт — подвеса; болты Поворот↔Уголок на 10 и 28 над плечом, как в параметрах Скелета.
2026-10-22 Ключ к болту: пересечение-null с зоной ключа — мимо
    Как в «гайках в углу»: Volume у null-формы бросает. Тест — подставное тело, у которого common отдаёт null.
2026-10-22 Ошибка «сбоку от Щита» без «пусто»
    Ошибка значит, что тело там есть: «сбоку от Щита пусто» противоречило само себе.
2026-10-22 Проверки Кронштейна: Уголок и Поворот из сцены — одной функцией
    angle_and_turn() отбрасывает отсутствующие и null-тела; порядок во всех трёх проверках — Уголок, Поворот.
    BEYOND — из Скелета, как в Дне и стопке.
2026-10-22 Тесты Кронштейна: assertError один на файл, болт подвеса из params
    assertError — в общем базовом классе проверок Кронштейна.
    Болт подвеса в тесте узла — от низа гайки в Крышке до BEYOND над верхом плеча, по spec; раньше числа вручную и конец ровно на верхе плеча.
2026-10-22 Тень: докстринги гайки подвеса без двусмысленности
    Гайка добавляется к преградам солнцу, а не исключается вместе с Заглушкой. Потолок гнезда считается заново: импорт из stack — цикл.
2026-10-22 Эскиз Кронштейна: Поворот — покупной Г-кронштейн с подкосом
    «Полочный кронштейн» в глоссарии — в Avoid у Поворота.
2026-10-22 Эскиз Поворота из KUL с оценкой ветра; 6а — переделка под профиль и KUL
    Уголок — L-профиль 40×40×2, Поворот — анкерный уголок KUL 40×200×40 без подкоса, Проставка Ø95. Эскиз показывает стык и даёт грубую оценку качания и напряжений по скорости ветра. Модель — тикет 10.
2026-10-22 Кронштейн из L-профиля и KUL, Проставка Ø95
    Уголок 40×40×2, Поворот — KUL 40×200×40 без подкоса, стенки паза Проставки вровень с плечом 2. Новая проверка «Проставка ↔ шайбы Шпилек»; тесты подкоса заменены тестами зоны ключа. Тикет 10.
